jonthompson/surfactuator/(commit log)

2018-02-26 Adding pin logic for deploy/retract
2018-02-26 Adding manual forceDeploy and button actions
2018-06-28 Fixing a hard coded pin
    [surfactuator.ino]
